kbeckmann/PicoCart64/hw/picocart64_v1/picocart64_v1.kicad_pcb

## KiCad design hw/picocart64_v1/picocart64_v1.kicad_pcb (2022-07-02, an earlier design)

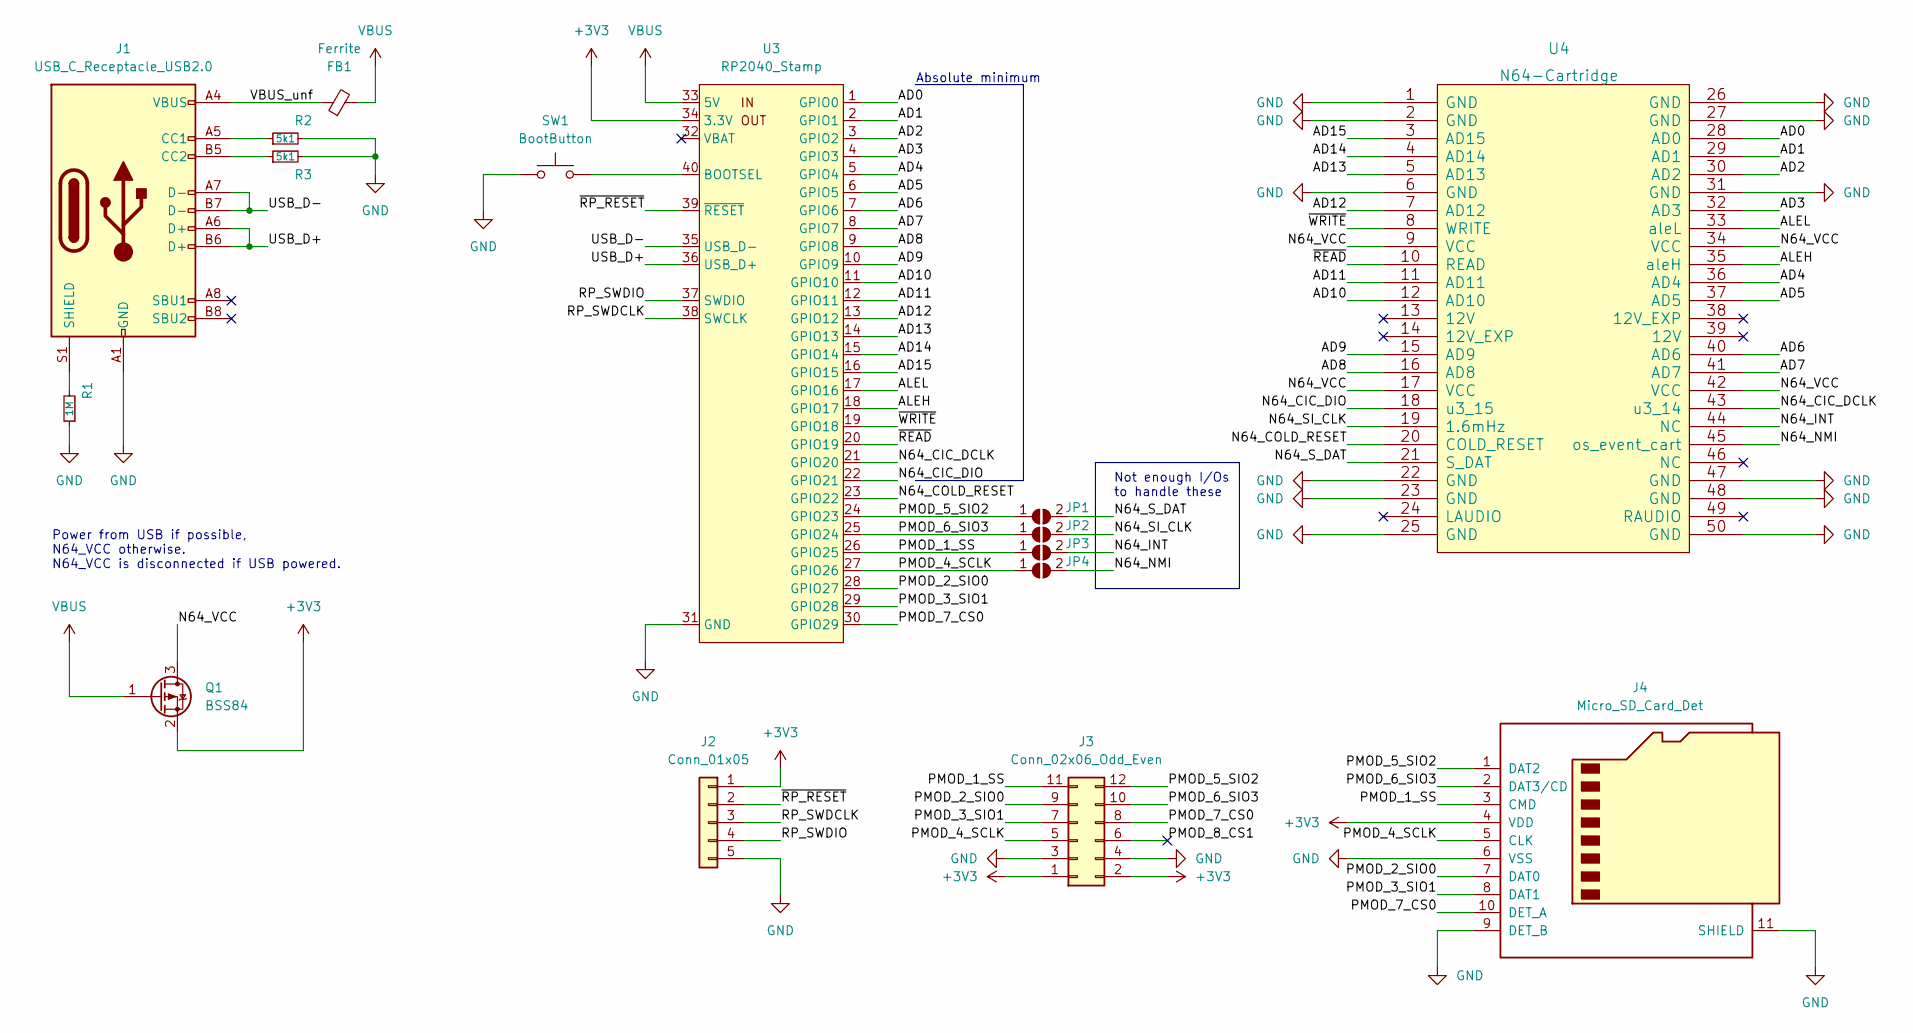
[picture p8: schematic picocart64_v1.kicad_sch, PicoCart64]

Parts:
FB1: Ferrite; L_0603_1608Metric
J1: USB_C_Receptacle_USB2.0; USB_C_Receptacle_GT-USB-7010
J2: Conn_01x05; PinHeader_1x05_P2.54mm_Vertical
J3: Conn_02x06_Odd_Even; PinSocket_2x06_P2.54mm_Horizontal
J4: Micro_SD_Card_Det; microSD_HC_Molex_104031-0811
JP1, JP2, JP3, JP4: SolderJumper_2_Open; SolderJumper-2_P1.3mm_Open_TrianglePad1.0x1.5mm
Q1: BSS84; SOT-23
R1: 1M; R_0603_1608Metric
R2, R3: 5k1; R_0603_1608Metric
SW1: BootButton; SW_SPST_FSMSM
U3: RP2040_Stamp; RP2040_Stamp_FlexyPin
U4: N64-Cartridge; N64-Connector

Connections:
+3V3: J2.1, J3.1, J3.2, J4.4 (VDD), Q1.2 (S), U3.34 (3.3V)
/AD0: U3.1 (GPIO0), U4.28 (AD0)
/AD1: U3.2 (GPIO1), U4.29 (AD1)
/AD2: U3.3 (GPIO2), U4.30 (AD2)
/AD3: U3.4 (GPIO3), U4.32 (AD3)
/AD4: U3.5 (GPIO4), U4.36 (AD4)
/AD5: U3.6 (GPIO5), U4.37 (AD5)
/AD6: U3.7 (GPIO6), U4.40 (AD6)
/AD7: U3.8 (GPIO7), U4.41 (AD7)
/AD8: U3.9 (GPIO8), U4.16 (AD8)
/AD9: U3.10 (GPIO9), U4.15 (AD9)
/AD10: U3.11 (GPIO10), U4.12 (AD10)
/AD11: U3.12 (GPIO11), U4.11 (AD11)
/AD12: U3.13 (GPIO12), U4.7 (AD12)
/AD13: U3.14 (GPIO13), U4.5 (AD13)
/AD14: U3.15 (GPIO14), U4.4 (AD14)
/AD15: U3.16 (GPIO15), U4.3 (AD15)
/ALEH: U3.18 (GPIO17), U4.35 (aleH)
/ALEL: U3.17 (GPIO16), U4.33 (aleL)
/N64_CIC_DCLK: U3.21 (GPIO20), U4.43 (u3_14)
/N64_CIC_DIO: U3.22 (GPIO21), U4.18 (u3_15)
/N64_COLD_RESET: U3.23 (GPIO22), U4.20 (COLD_RESET)
/N64_INT: JP3.2 (B), U4.44 (NC)
/N64_NMI: JP4.2 (B), U4.45 (os_event_cart)
/N64_SI_CLK: JP2.2 (B), U4.19 (1.6mHz)
/N64_S_DAT: JP1.2 (B), U4.21 (S_DAT)
/N64_VCC: Q1.3 (D), U4.9 (VCC), U4.17 (VCC), U4.34 (VCC), U4.42 (VCC)
/PMOD_1_SS: J3.11, J4.3 (CMD), JP3.1 (A), U3.26 (GPIO25)
/PMOD_2_SIO0: J3.9, J4.7 (DAT0), U3.28 (GPIO27)
/PMOD_3_SIO1: J3.7, J4.8 (DAT1), U3.29 (GPIO28)
/PMOD_4_SCLK: J3.5, J4.5 (CLK), JP4.1 (A), U3.27 (GPIO26)
/PMOD_5_SIO2: J3.12, J4.1 (DAT2), JP1.1 (A), U3.24 (GPIO23)
/PMOD_6_SIO3: J3.10, J4.2 (DAT3/CD), JP2.1 (A), U3.25 (GPIO24)
/PMOD_7_CS0: J3.8, J4.10 (DET_A), U3.30 (GPIO29)
/PMOD_8_CS1: J3.6
/RP_SWDCLK: J2.3, U3.38 (SWCLK)
/RP_SWDIO: J2.4, U3.37 (SWDIO)
/USB_D+: J1.A6 (D+), J1.B6 (D+), U3.36 (USB_D+)
/USB_D-: J1.A7 (D-), J1.B7 (D-), U3.35 (USB_D-)
/VBUS_unf: FB1.1, J1.A4 (VBUS), J1.A9 (VBUS), J1.B4 (VBUS), J1.B9 (VBUS)
/~READ: U3.20 (GPIO19), U4.10 (READ)
/~RP_RESET: J2.2, U3.39 (~RESET)
/~WRITE: U3.19 (GPIO18), U4.8 (WRITE)
GND: J1.A1 (GND), J1.A12 (GND), J1.B1 (GND), J1.B12 (GND), J2.5, J3.3, J3.4, J4.6 (VSS), J4.9 (DET_B), J4.11 (SHIELD), R1.1, R2.2, R3.2, SW1.1, U3.31 (GND), U4.1 (GND), U4.2 (GND), U4.6 (GND), U4.22 (GND), U4.23 (GND), U4.25 (GND), U4.26 (GND), U4.27 (GND), U4.31 (GND), U4.47 (GND), U4.48 (GND), U4.50 (GND)
unnamed: J1.A5 (CC1), R2.1
unnamed: J1.B5 (CC2), R3.1
unnamed: J1.S1 (SHIELD), R1.2
unnamed: SW1.2, U3.40 (BOOTSEL)
VBUS: FB1.2, Q1.1 (G), U3.33 (5V)

Notes on the sheet:
Power from USB if possible, N64_VCC otherwise. N64_VCC is disconnected if USB powered.
Not enough I/Os to handle these
Absolute minimum

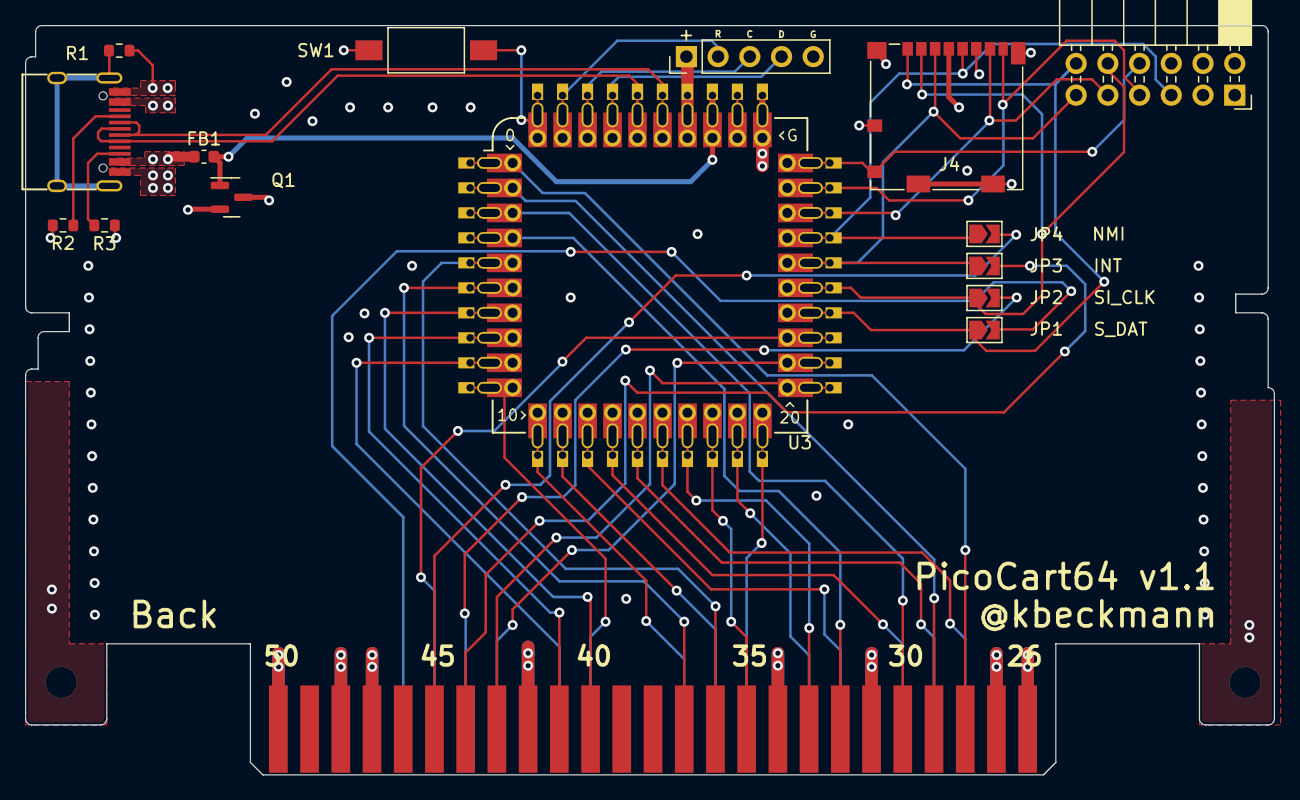
[picture p9: board picocart64_v1.kicad_pcb from above]

Board: 4 copper layers, 100.0 x 60.0 mm, 16 parts (1 on the bottom side), 48 nets.
